vtattyba/NASA-Micro-G-NeXT/AMSAR 1.0/2020 Congrats.jpg

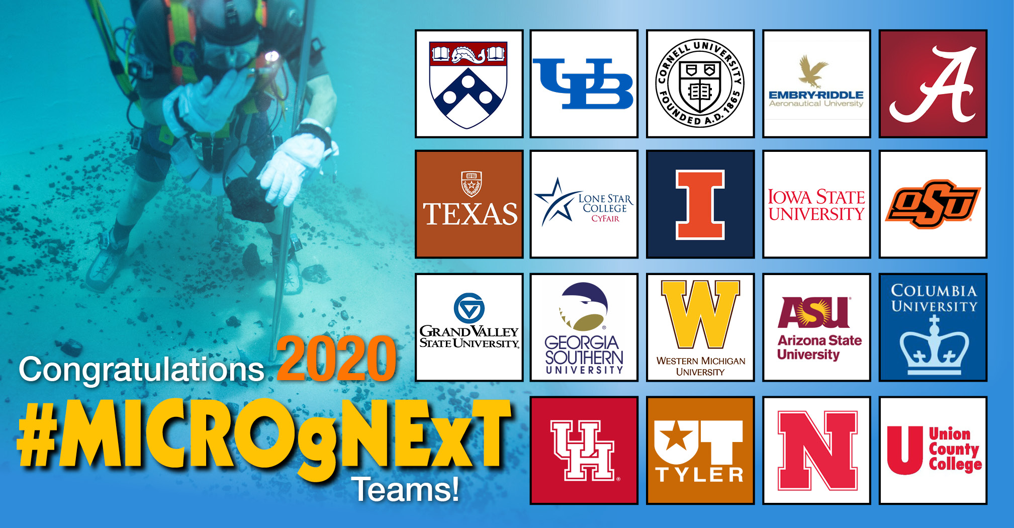
AMSAR 1.0/2020 Congrats.jpg
