vtattyba/NASA-Micro-G-NeXT/AMSAR 1.0/Electronics/custom_pcb.jpg

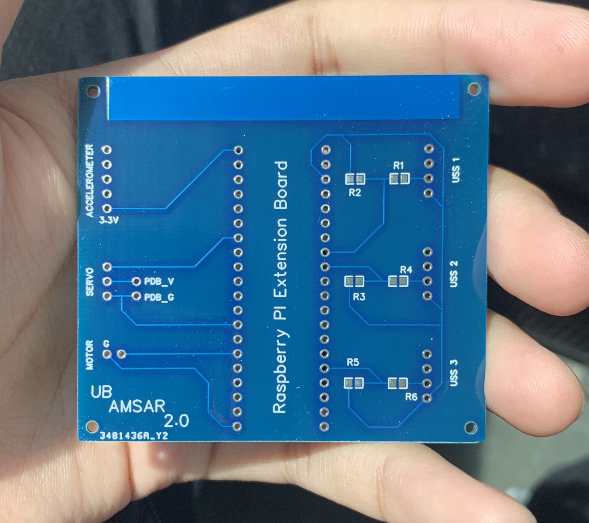
AMSAR 1.0/Electronics/custom_pcb.jpg
