vtattyba/NASA-Micro-G-NeXT/AMSAR 1.0/Electronics/pcb.jpg

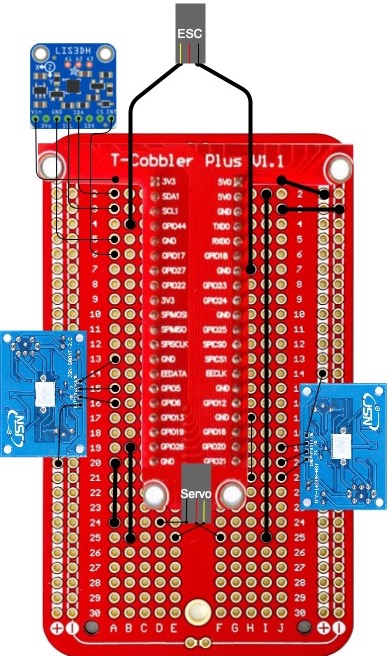
AMSAR 1.0/Electronics/pcb.jpg
