vtattyba/NASA-Micro-G-NeXT/AMSAR 1.0/Media/F1707ED7-14AC-41B5-A841-EFC2B58373EA.JPEG

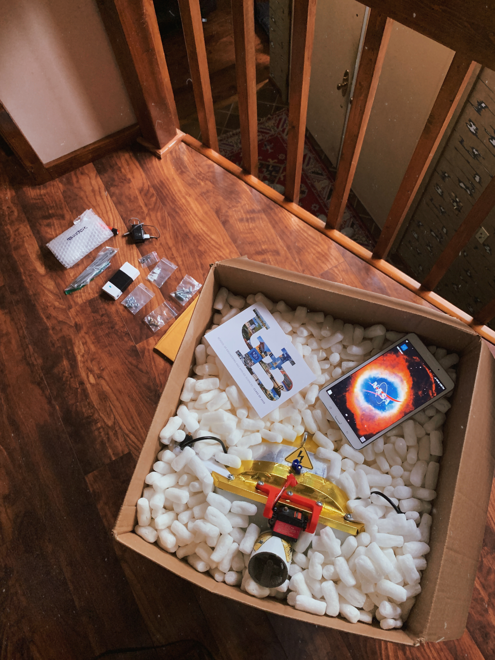
AMSAR 1.0/Media/F1707ED7-14AC-41B5-A841-EFC2B58373EA.JPEG
