vtattyba/NASA-Micro-G-NeXT/AMSAR 1.0/Research/IMG_2271.PNG

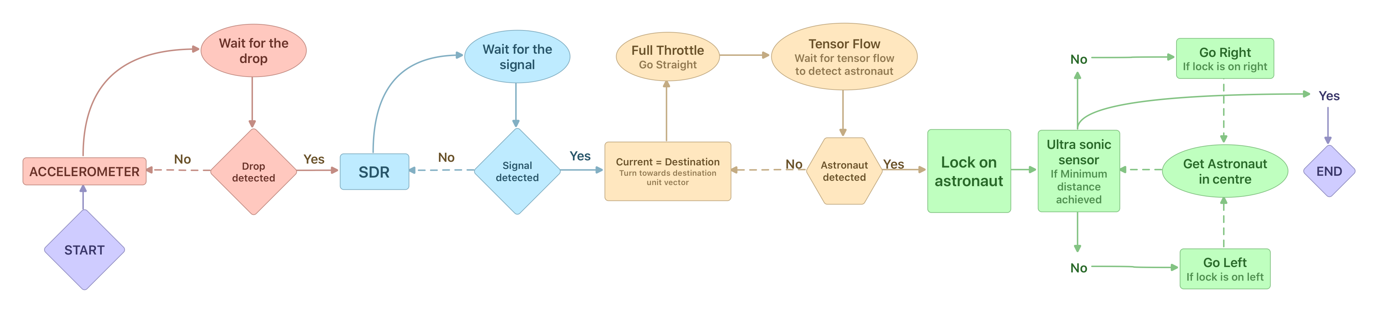
AMSAR 1.0/Research/IMG_2271.PNG
