vtattyba/NASA-Micro-G-NeXT/AMSAR 1.0/Research/Team Research and Development/Basic Function Analysis.jpg

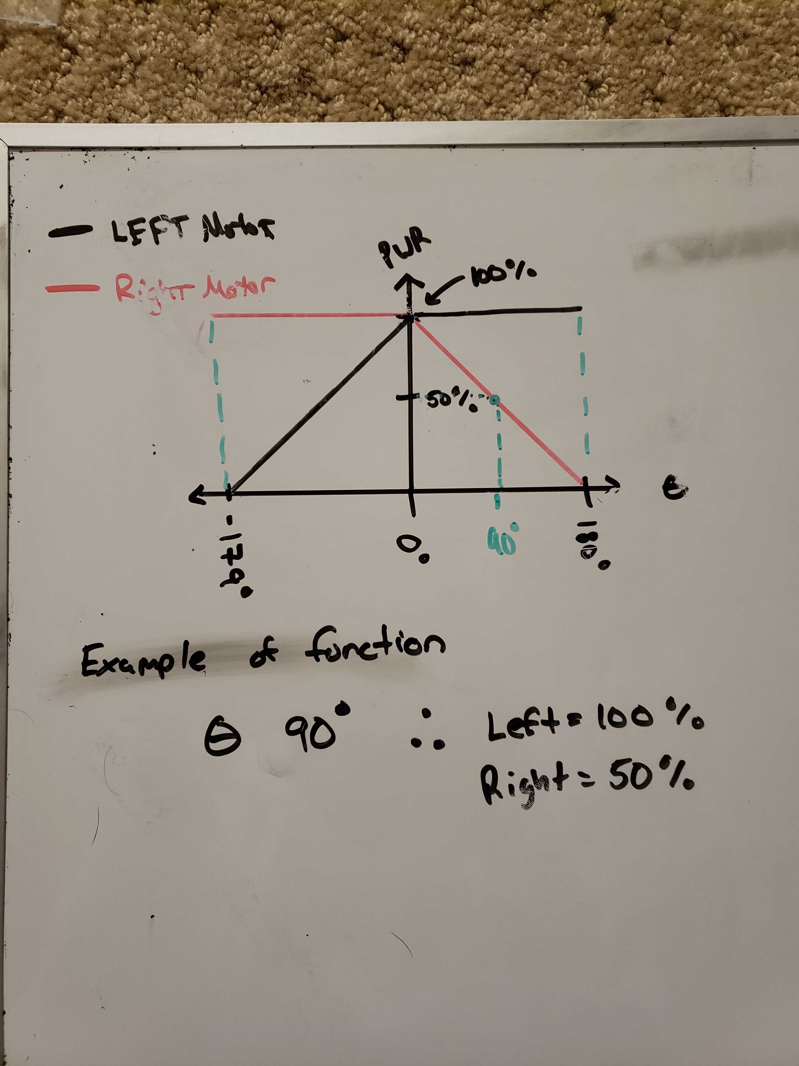
AMSAR 1.0/Research/Team Research and Development/Basic Function Analysis.jpg
