vtattyba/NASA-Micro-G-NeXT/AMSAR 1.0/Research/Team Research and Development/Basic Motor Function (Can Ignore).jpg

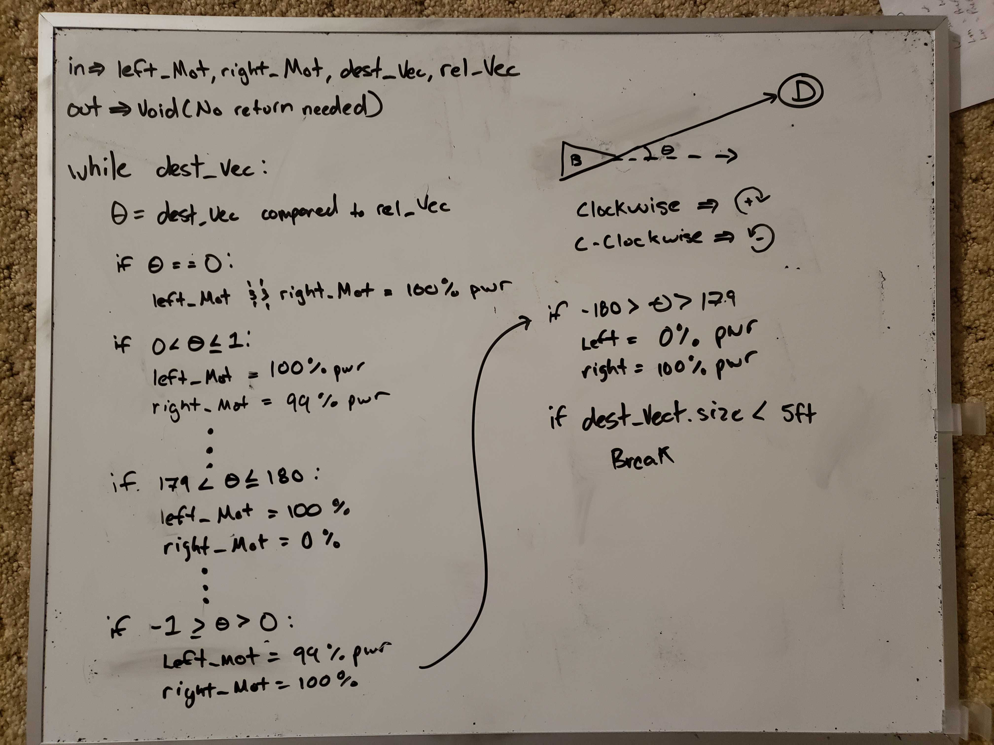
AMSAR 1.0/Research/Team Research and Development/Basic Motor Function (Can Ignore).jpg
