vtattyba/NASA-Micro-G-NeXT/AMSAR 1.0/Research/Team Research and Development/Image from iOS.jpg

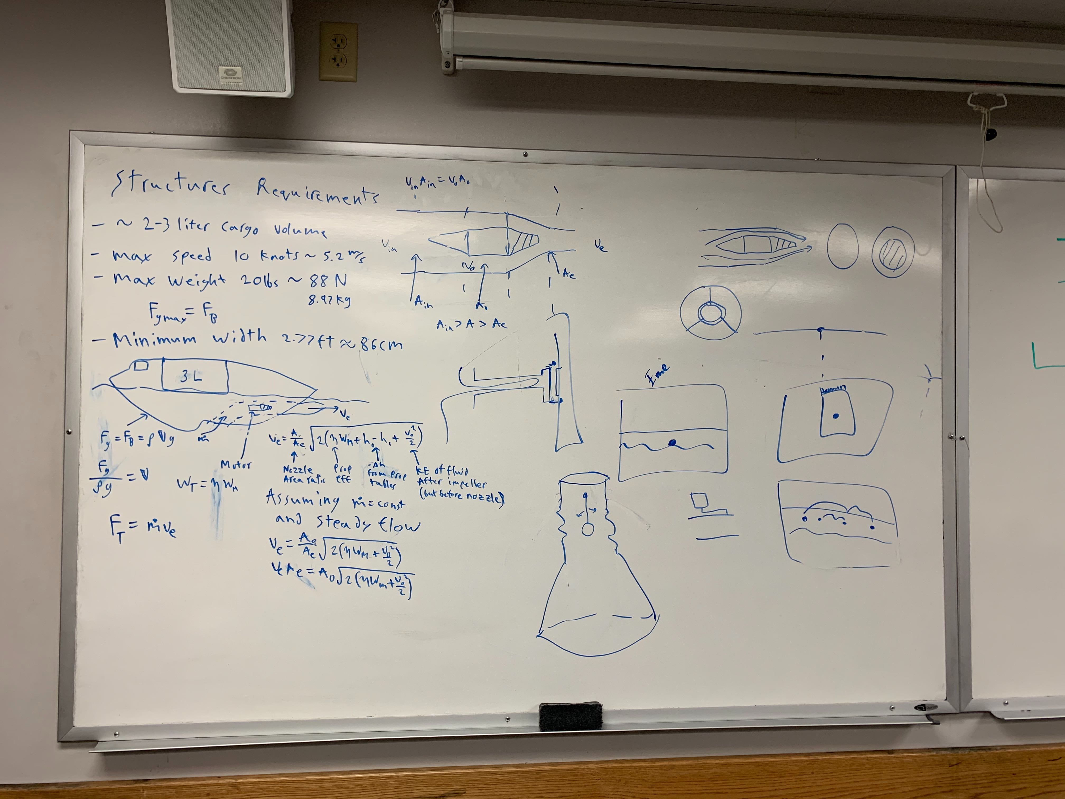
AMSAR 1.0/Research/Team Research and Development/Image from iOS.jpg
