vtattyba/NASA-Micro-G-NeXT/AMSAR 2.0/Electronics/Circuit-2.png

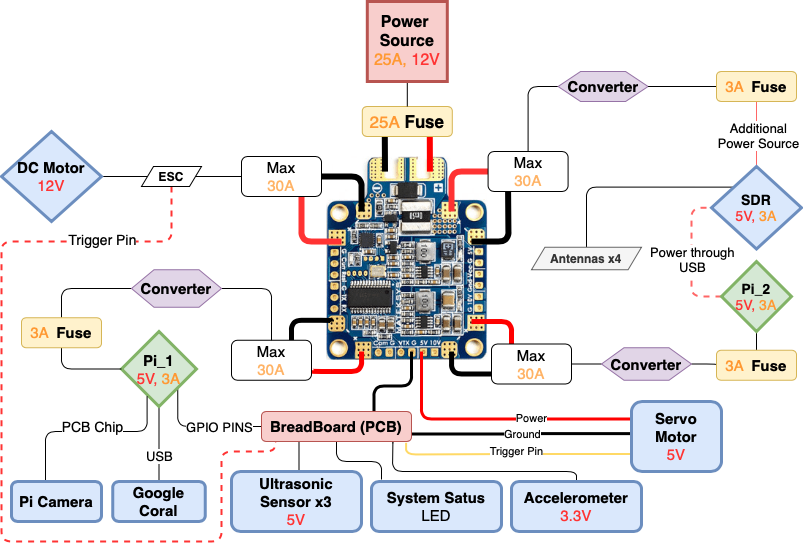
AMSAR 2.0/Electronics/Circuit-2.png
