vtattyba/NASA-Micro-G-NeXT/AMSAR 2.0/Electronics/Custom_PCB.jpg

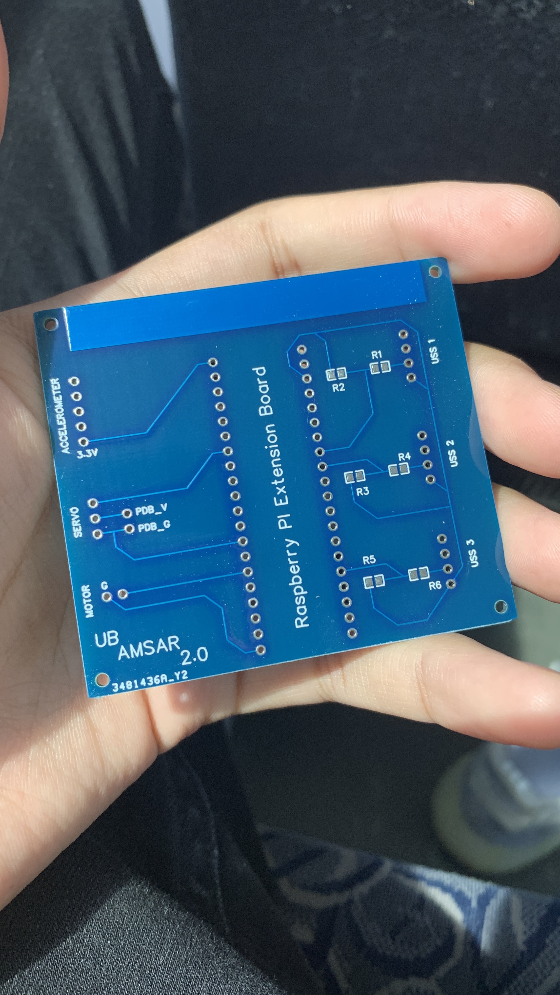
AMSAR 2.0/Electronics/Custom_PCB.jpg
