vtattyba/NASA-Micro-G-NeXT/AMSAR 2.0/Electronics/IMG_9858.jpg

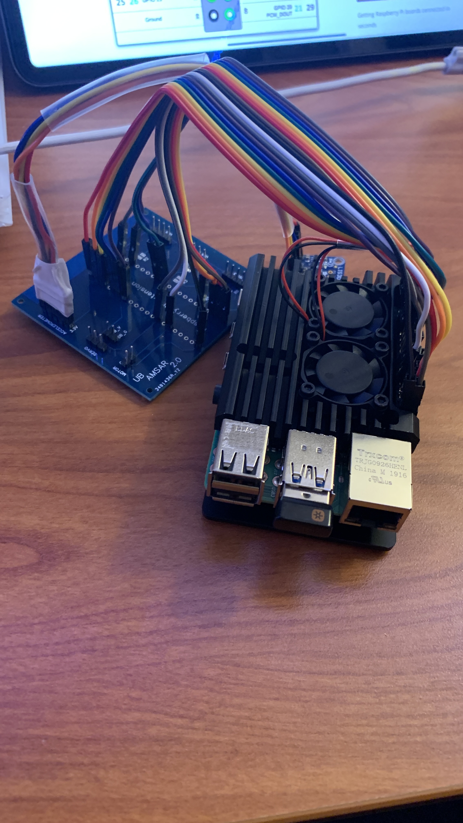
AMSAR 2.0/Electronics/IMG_9858.jpg
