vtattyba/NASA-Micro-G-NeXT/AMSAR 2.0/Software/USS/Screen Shot 2020-08-11 at 8.34.05 PM.png

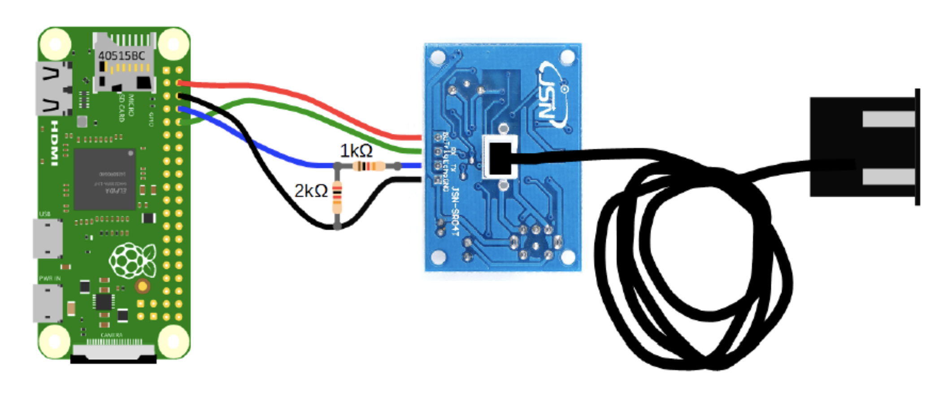
AMSAR 2.0/Software/USS/Screen Shot 2020-08-11 at 8.34.05 PM.png
