vtattyba/NASA-Micro-G-NeXT/AMSAR 2.0/Structures/IMG_9707.jpg

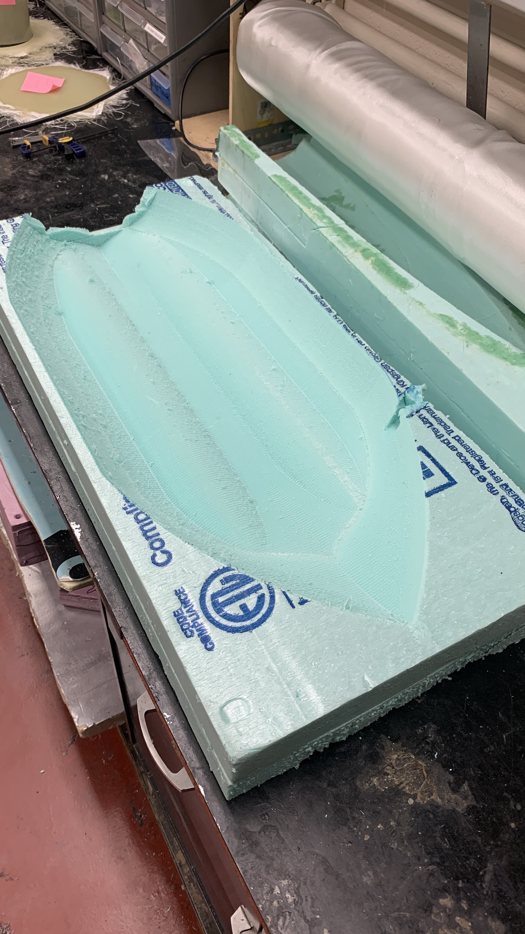
AMSAR 2.0/Structures/IMG_9707.jpg
