vtattyba/NASA-Micro-G-NeXT/AMSAR 2.0/Structures/IMG_9727.JPG

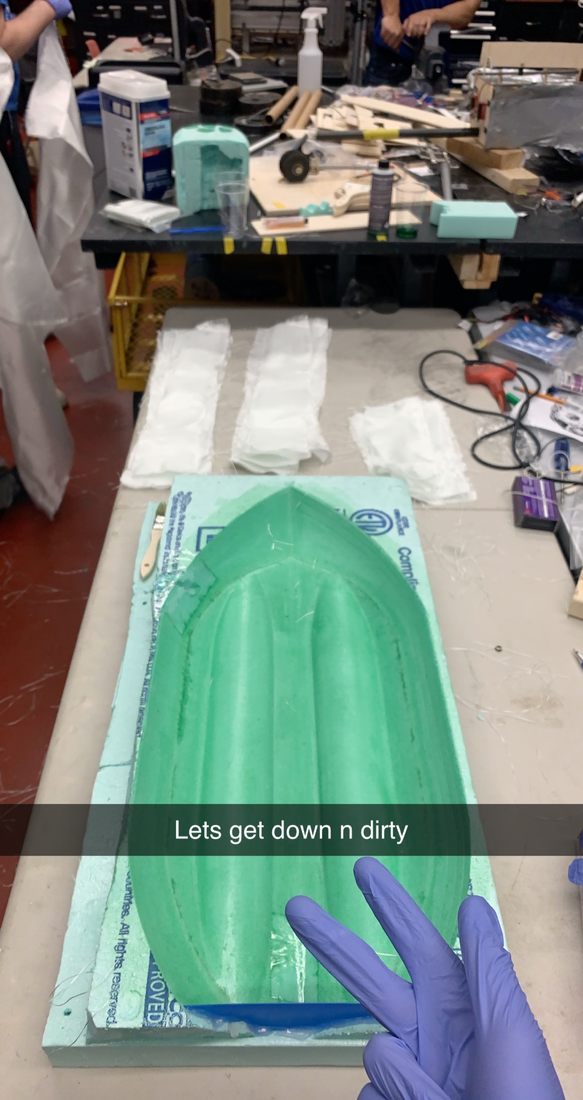
AMSAR 2.0/Structures/IMG_9727.JPG
