vtattyba/NASA-Micro-G-NeXT/AMSAR 1.0/Research/External Research and Citations/Making an Autonomous Boat Using a Raspberry Pi (WiP)_ 14 Steps (with Pictures).html

Instructables instructablescircuitsProjectsCommunity

# Making an Autonomous Boat Using a Raspberry Pi (WiP)

By SilverJimny in CircuitsRaspberry Pi

195,056

539

40

Featured

license StatsDownloadFavorite

 By SilverJimnyCheck out my thingiverse models (https://www.thingiverse.com/GregoryHolloway/designs)Follow

More by the author:

An Electric Musical Instrument 3D Printed Amplifier.

Astrophotography With the Raspberry Pi Zero.

Glow-In-The-Dark Nuclear Bomb Night Light.

About: A passionate make of things. I spend my time developing new ideas and looking for ways to improve old ones! More About SilverJimny »

The wave of enthusiasm for the Raspberry Pi (http://raspberrypi.org) has driven many people to wonder at the possibilities, and marvel at it's simplicity. The credit card sized SBC (http://en.wikipedia.org/wiki/Single-board_computer) is perfect for just about anything. Maybe even for crossing the Atlantic Ocean.

FishPi (http://fishpi.org) is a project with the goal of doing just that and crossing the Atlantic, using the Raspberry Pi to pilot the craft. The first step in this project is the Proof-Of-Concept Vehicle (POCV).

The POCV will test the basic principles of autonomous control with a Raspberry Pi, and I'm going to show you how to make your own.

 (http://steps-per-mm.xyz)

Love 3D printing? Love T-Shirts?

Then you need to check out steps-per-mm.xyz!

It is loaded with a huge range of wearable Parts & Components.

Add TipAsk QuestionCommentDownload

Teacher Notes

Teachers! Did you use this instructable in your classroom?
Add a Teacher Note to share how you incorporated it into your lesson.

Add Teacher Note

Step 1: Parts

The core components used in the FishPi Proof-Of-Concept Vehicle are;

Model B Raspberry Pi (http://raspberrypi.org).
8gb SD Card (http://elinux.org/RPi_VerifiedPeripherals#SD_cards).
Models By Design Fibre Glass Hull (http://modelsbydesign.co.uk/Default.aspx).
Models By Design 40mm Kort Nozzle (http://modelsbydesign.co.uk/Default.aspx).
Raspy Juice (https://code.google.com/p/raspy-juice/).
Flytron Navigatron V2 i2c GPS (http://www.flytron.com/sensors/180-i2c-gps-for-multiwii-and-others.html).
CMPS10 - Tilt Compensated Compass Module (http://www.robot-electronics.co.uk/htm/cmps10doc.htm).
Adafruit 16-Channel 12-bit PWM/Servo Driver - i²c interface - PCA9685 (http://www.adafruit.com/products/815).
Mtronics MicroViper Marine10 Electronic Speed Controller (ESC) (http://www.mtroniks.net/details1.asp/ProductID/185/MicroViper-marine10.htm) .
MFA 919D 540 Motor With Attached Single Ratio Metal Gearbox 2.5:1 (http://www.cornwallmodelboats.co.uk/acatalog/MFA_919D251.html).
Raboesch Brass 4 Bladed Kort Propeller (http://www.cornwallmodelboats.co.uk/acatalog/R149-M4.html).
Raboesch Waterproof Propshaft (http://www.cornwallmodelboats.co.uk/acatalog/Raboesch_Precision_Propshafts.html).
Kinobo 5 Megapixel USB Webcam (http://www.amazon.co.uk/Kinobo-Megapixel-Webcam-Ubuntu-Desktop/dp/B002UAV8LS).
Six 5000mAH 1.2 Volt NiMH SubC cells (http://www.component-shop.co.uk/html/single_cells.html).
Flytron 3.3v & 5v Tiny Regulators (http://www.flytron.com/camera-transmitter-shutter/93-tiny-5volt-regulator.html).
Digital Temperature Sensor Breakout - TMP102 (https://www.sparkfun.com/products/9418).

Tools;

All of them (http://en.wikipedia.org/wiki/Tool).

Additional Parts Used (Update One 18/3/13);

TP-Link TL-WN722N High-Gain Wi-Fi USB Dongle (http://uk.tp-link.com/products/details/?model=TL-WN722N).
RockBLOCK Satellite Communicator (http://rockblock.rock7mobile.com/).
SMA Female to SMA Male Panel Mount Pigtail Extension Cable (http://www.ebay.co.uk/itm/30cm-RP-SMA-Male-to-Female-Pigtail-WLAN-Network-RF-Antenna-RG316-Coaxial-Cable-/230717310910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).
2x 45mm M3 Spacers (http://uk.farnell.com/jsp/search/productdetail.jsp?SKU=1466727).

Please help support my work here on Instructables (https://www.instructables.com/member/SilverJimny/) and on Thingiverse (https://www.thingiverse.com/GregoryHolloway/)
by using the following affiliate links when making purchases. Thanks :)

eBay.com (https://rover.ebay.com/rover/1/711-53200-19255-0/1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) | eBay.co.uk (https://rover.ebay.com/rover/1/710-53481-19255-0/1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) | eBay.fr (https://rover.ebay.com/rover/1/709-53476-19255-0/1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) | Amazon.co.uk (http://amzn.to/2svRleo)

Add TipAsk QuestionCommentDownload

Step 2: The Incredible Hull

The hull I am using for the POCV is based on the Cygnus Marine DS25 (http://www.cygnusmarine.com/boats/specs/specs.asp?lMdl=5) Fishing Boat. It is made by a company called Models By Design (http://modelsbydesign.co.uk/), they specialise in G.R.P. model boats. The hull costs a little over £20, perfect for low budgets.

To begin with the basic components going into the hull are the Motor, Kort Nozzle, Propshaft, Propeller, and servo. The DS25 is not designed to run a Kort nozzle (http://en.wikipedia.org/wiki/Ducted_propeller), but as this system works well at low RPM and high torque, I decided to trial the Kort system with a view to using it in our larger vessels.

The first step is to find the centre line of the hull. To do this is I simply held a ruler against one side of the keel and carefully drew a line along the underside of the model. Repeating this on the opposite edge put two lines on the underside. Next it was just a case of measuring the distance between the two lines and marking up the centre.

To locate holes for the Kort nozzle I had to approximate where the nozzle would be best situated, I did this by viewing the hull side on and taking measurements to get the correct distances.

Inside the hull is a wooden support. This support forms the upper brace for the Kort nozzle, and provides the lower brace for the rudder servo. The support is held in with epoxy resin.

Once the Kort was fitted I used a similar method to locate a hole for the propshaft. The hole for the propshaft was slightly elongated to allow for minor adjustment in height. As long as the elongation was in the vertical plane there should be no deviation off centre in the horizontal. Before finally cementing the propshaft with epoxy take note to align the propshaft with enough room to give the propeller clearance inside the Kort nozzle, even when the nozzle is being steered.

I found that by following the mantra of measure three times, cut once, I reached an accuracy of about 0.5 of a mm when positioning the propeller.

Add TipAsk QuestionCommentDownload

Step 3: Shafted

The MFA 919D 540 Motor (http://www.cornwallmodelboats.co.uk/acatalog/MFA_919D251.html) is fitted with a single ratio gearbox. It increases the motor's torque, but lowers the RPM. It should have no problems driving the 40mm Kort propeller.

The motor needs a strong base to mount onto inside the hull. The underside of the mount is angled to match the slope of the hull. A centre pane slots into the keel giving additional strength.

At the rear the upper servo bracket is added. A universal joint connects the motor output to the propshaft. Some time must be spent correctly aligning the two before permanently fixing the propshaft and motor mount in place.

Add TipAsk QuestionCommentDownload

Step 4: Elastictrickery

Electricity & electronics do not fair well in water. I thought sometime about how to enclose the electronics in a watertight compartment. I looked at several options and in the end I settled on a plastic food storage box.

Why? Well it was cheap, about £3, there are no screws to secure the lid, and they are watertight. The particular box I chose had enough space for the Raspberry Pi, and the four clips which secured the lid to the base were on the lid itself. By building the electronics onto the lid and effectively turning the tub upside down I could un-clip the tub proper so that when it is removed all the electronics are easily accessible.

I cut & shaped a plywood board which would rest inside the lid.The whole assembly is screwed to two cross-members fixed inside the POCV's hull. The two side clips were removed from the lid so the assembly can sit lower in the hull. Onto the wood panel I glued a shaped foam pad, from a Yoga mat, which the Raspberry Pi sits on, and fitted three brackets to hold the Raspberry Pi in position. With the tub, now the lid, clipped in place the enclosure is completely watertight. For now anyway!

Add TipAsk QuestionCommentDownload

Step 5: Wired

Originally the plan was to connect the POCV to a Base-Station via a wired link called we termed as the umbilical. The link would provide connectivity for USB, HDMI, & CAT5e. In total there were 32 separate wires across the USB, HDMI, and Network cables. The design utilised a 32 pin aviation style connector and a 2 metre cable.

Wires would connect to the Raspberry Pi, pass through the lid of the watertight compartment and into the 32-pin connector. This would then be replicated at the other end where the cable would plug into an LCD, USB hub, and a offer a network connection.

Recently this system has been removed as it caused too many problems. The umbilical is being replaced with a Wifi link. Details of this conversion are shown later on.

Add TipAsk QuestionCommentDownload

Step 6: Staying Power

Six 1.2v 5000mAh SubC NiMh batteries. Quite a mouthful, they all need securely fitting into the POCV's hull, along with a switch control box.

The box switches the battery connections between a DC socket, and supplying power to the POCV. By plugging a NiMh charger into the DC socket, and with the switch it in the correct position we can charge the six cells without needing to remove them from inside the hull.

To help balance the board I put two at the rear, below the tub, and four at the front. They are held in with tie-wraps. I have used several connectors so that the batteries can be removed if necessary.

Add TipAsk QuestionCommentDownload

Step 7: Power Rails

The six NiMh cells are arranged in series, this gives 7.2 volts. The Raspberry Pi works off 5 volts, and the i2c rail needs 3.3 volts.

I bought two 5v, and a single 3.3v LDO regulator from Flytron (http://flytron.com/). The extra 5v would be used for any other devices, like a webcam and the Adafruit PWM, that would be built into the POCV.

The LDOs convert any difference in voltage (7.2v to 5v, 3.3v) into heat. I used a passive heat-sink removed from an old mainboard, cut it into lengths that loosely matched the shape of the LDOs, and then strapped the LDOs to the heat-sink with a bit of thermal pad between the LDO and the heat-sink. This design was later updated where the tie-wraps and thermal pads were replaced with thermal adhesive. The three LDOs are screwed to tabs glued onto the wood panel.

The i2c rails are made from strip-board. Lines for +v, gnd, SDA, & SLC, are connected with 2.54mm pins. 3.3v is fed from the 3.3v LDO. Included on the i2c rails are two 1k8 pick-up resistors.

Mounted to wooden blocks at the front is the Mtronics MicroViper Marine10 (http://www.mtroniks.net/details1.asp/ProductID/185/MicroViper-marine10.htm) ESC.

Add TipAsk QuestionCommentDownload

Step 8: The Little Things

The TMP102 Temperature Sensor (https://www.sparkfun.com/products/9418), Navigatron v2 GPS (http://www.flytron.com/sensors/180-i2c-gps-for-multiwii-and-others.html), CMPS10 Compass (http://www.robot-electronics.co.uk/htm/cmps10doc.htm), and the Adafruit 16 Channel PWM (http://www.adafruit.com/products/815) all connect to the i2c rails using 2.54mm pins. By encasing DuPont connectors in wood, and then gluing them to the wood panel I was able to fit all the devices into the tub, and make them all removable.

CMPS10 Compass needs to be as far away from other electronics as it is susceptible to interference. The compass is mounted inside a plastic box on a mast at the front of the POCV.

To check that all the power systems work the POCV is plugged into an LCD and turned on.

Add TipAsk QuestionCommentDownload

Step 9: I Spy

The small form factor of the Kinobo Webcam (http://www.amazon.co.uk/Kinobo-Megapixel-Webcam-Ubuntu-Desktop/dp/B002UAV8LS) combined with its practical rectangular shape are the main reasons for picking this camera.

One of our goals is to be able to record and hopefully transmit live images back from the mid Atlantic. I decided early on that adding in a webcam would be a addition to the POCV. The Raspberry Pi Foundation (http://raspberrypi.org) are developing a camera to work with the Raspberry Pi, but at the time of writing this the camera is not currently available.

Add TipAsk QuestionCommentDownload

Step 10: Spray 'N Pray

Take care when masking the hull making sure to to cover the holes, plastic parts, and any other areas where you do not want paint. I used a bin liner and modelling masking tape.

The model is hung outside on a modified wire coat hanger for spraying.

The lettering is Letraset Transfers (http://www.letraset.com/products/91-Lettering/). The letters are applied after painting, and several coats of protective varnish are sprayed over the top. The interior of the hull also gets a few coasts of the protective varnish.

The hooks around the edge are one part of a Hook & Eye (http://en.wikipedia.org/wiki/Hook-and-eye_closure) system designed to hold a cloth cover over the top of the POCV.

Add TipAsk QuestionCommentDownload

Step 11: Putting It Together

Putting the POCV together for the final assembly I had to pass the wires through the wood panel and solder the 32 separate wires to the 32-pin connector. The first attempt didn't work very well and I had to rebuild the entire cable, at both ends, using heatshrink over all the pins where the wire soldered on. In the end it proved to complicated too make it a practical solution.

Add TipAsk QuestionCommentDownload

Step 12: The First Modification

As with all prototypes, things need altering from their original design. The first modification to the POCV was the Raspy Juice (https://code.google.com/p/raspy-juice/). The LDO supplying the Raspberry Pi with 5v was getting very hot, even with the heat-sink. Luckily FishPi had been sent two Raspy Juice beta boards for testing so it was a simple case of unplugging the LDO and wiring in the Raspy Juice.

The next upgrade was the USB hub. Removing the umbilical and installing a Wifi link between the POCV and the Base-Station. The power needs of the Wifi Dongle would exceed the capabilities of the Raspberry Pi's on-board USB. So a powered USB hub was needed. I had an old 4-Port un-powered USB hub which I modified to take a 5v feed from the unused LDO which used to power Raspberry Pi.

There are still a few additions to go onto the POCV, including a Satellite Communications Module (RockBLOCK (http://rockblock.rock7mobile.com/)), I will post updates as the Proof-Of-Concept Vehicle's development grows.

Add TipAsk QuestionCommentDownload

Step 13: Software

Good software is the life & soul of every project.

FishPi is no different. The Command & Control software under development for the POCV is open source. We have a repository on GitHub (link (http://github.com/FishPi/FishPi-POCV---Command---Control)) where you can download a copy of your own, or help with development and fork from our repository. You can follow software development updates on twitter @TheFishPi_Dev (http://twitter.com/TheFishPi_Dev).

For now we have manual control of the POCV through the Command & Control software. Al Gray, our lead programmer, is working hard to adjust the system to handle the new remote requirements imposed by the substitution of the umbilical for a Wifi link.

Ultimately we should have a system capable of autonomous navigation, satellite communications, live video feeds, and remote control. The Command & Control program should also work on any vehicle type, not just boats.

For more information about FishPi please visit our website http://www.fishpi.org, join our forum http://fishpi.org/forum/, or follow us on twitter @TheFishPi (http://twitter.com/TheFishPi). We also have a wiki if you're looking for the full technical details http://wiki.fishpi.org/

Add TipAsk QuestionCommentDownload

Step 14: 18 March 2013 | Update One

There has been an alteration to the FishPi's communications. The 32-core umbilical has been removed, and a Wi-Fi link has been fitted in it's place. I'll also be adding in a RockBLOCK Satellite Communicator (http://rockblock.rock7mobile.com/).

After checking the eLinux.Org list of Raspberry Pi Verified Peripherals (http://elinux.org/Rpi_Low-level_peripherals) for a compatible Wi-Fi dongle I chose the TP-Link TL-WN722N. The TP-Link has a detachable High-Gain Antenna which will be perfect to use with an RF extension.

The first job is to remove all the unwanted plastic casing from the dongle. Because I will be soldering a wire to the dongle I have also unsoldered the USB plug.

There isn't much space left inside the lunch-box enclosure so the RockBLOCK will be mounted on PCB supports where it will sit above the Raspberry Pi. I used eight 12mm M3 brass supports during the modification, but I have since replaced them with two 45mm M3 supports.

The Wi-Fi Dongle sits vertically inside two notched wooden support posts, one is permanently fixed but the other is held in by a screw. Both the Wi-Fi Dongle and the RockBLOCK have USB cables soldered directly to the PCBs.

The lunch-box base, now the cover, has been drilled and an RF extension cable mounted inside the hole. The antenna which somes with the Wi-Fi Dongle has been screwed to the extension. The other end of the RF extension attaches to the Wi-Fi Dongle.

Additional Parts Used;

TP-Link TL-WN722N High-Gain Wi-Fi USB Dongle (http://uk.tp-link.com/products/details/?model=TL-WN722N).
RockBLOCK Satellite Communicator (http://rockblock.rock7mobile.com/).
SMA Female to SMA Male Panel Mount Pigtail Extension Cable (http://www.ebay.co.uk/itm/30cm-RP-SMA-Male-to-Female-Pigtail-WLAN-Network-RF-Antenna-RG316-Coaxial-Cable-/230717310910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).
2x 45mm M3 Spacers (http://uk.farnell.com/jsp/search/productdetail.jsp?SKU=1466727).

The Base-Station is now an instructable too | Creating A Base-Station For Use With An Autonomous Vehicle (https://www.instructables.com/id/Creating-a-Base-Station-for-Use-With-An-Autonomous/).

Add TipAsk QuestionCommentDownload

UP! Contest
Participated in the
UP! Contest
View Contest

2 People Made This Project!

not an autonomous on...-chalei
chalei made it!

This project gave me...-comsa42
comsa42 made it!

Did you make this project? Share it with us!
I Made It!

Recommendations

Ultimate Dry Ice Machine - Bluetooth Controlled, Battery Powered and 3D Printed.

Ultimate Dry Ice Machine - Bluetooth Controlled, Battery Powered and 3D Printed.

by DIY Machines in Circuits

Commodore 64 Revamp With Raspberry Pi, Arduino and Lego

Commodore 64 Revamp With Raspberry Pi, Arduino and Lego

by RaspberryPioneer in Raspberry Pi

ILC1-1/8L Clock

ILC1-1/8L Clock

by ChristineNZ in Arduino

Internet of Things Class
Internet of Things Class
Internet of Things Class

22,645 Enrolled

Made with Math Contest
Made with Math Contest

Multi-Discipline Contest
Multi-Discipline Contest

Robotics Contest
Robotics Contest

40 Discussions

0

None

DanRadin
2 years ago

ReplyUpvote

Hi, thank you for sharing your great project. I am a math, science, and technology teacher at a small school http://www.panajachelcolegio.org/ on Lake Atitlan in Guatemala. We have a lot of problems with garbage in the lake. My students and I are thinking of building an autonomous boat to travel around the shore of the lake cleaning up garbage. I am thinking of using your instructable to build a miniature prototype. Perhaps you would like to collaborate with us.

0

None

Wallie45
2 years ago

ReplyUpvote

Hey any update on this? Do you still have the program for running the boat?

0

None

gaurav_sharma132
3 years ago

ReplyUpvote

What range did you able get with that wifi dongle concerning video feed and all ?

0

None

gaurav_sharma132
3 years ago

ReplyUpvote

What range did you able get with that wifi dongle concerning video feed and all ?

0

None

DavidGuo
3 years ago

ReplyUpvote

Good job! I think the LoRa/GPS HAT must be a good choice if you try to use the Wireless Lora Protocol at your project !

1 reply

0

None

DavidGuoDavidGuo
Reply 3 years ago

ReplyUpvote

LoRa/GPS HAT

http://wiki.dragino.com/index.php?title=Lora/GPS_HAT

0

None

NateS14
3 years ago

ReplyUpvote

So I want to create a small version that goes in my pond and livestream the fish. Is there a way to have it just drive around the pond randomly?

0

None

ZachSchleder
4 years ago on Introduction

ReplyUpvote

0

None

royalhackerx
4 years ago on Introduction

ReplyUpvote

i want its Pdf with circuit diagram how can i get it???

1 reply

0

None

SilverJimnyroyalhackerx
Reply 4 years ago on Introduction

ReplyUpvote

There isn't one available so you'd have to make one.

0

None

thebarboy
4 years ago on Introduction

ReplyUpvote

sorry, I will try with ardiuno. can ı do ?, and can u help to me ?

1 reply

0

None

SilverJimnythebarboy
Reply 4 years ago on Introduction

ReplyUpvote

You probably can do but I don't know how!

Google it :)

0

None

kane71270
5 years ago on Step 13

ReplyUpvote

I don't understand how you will transfer live feed with the limitations that RockBlock's 340 byte message limitation. Could you go into more details on this?

1 reply

0

None

SilverJimnykane71270
Reply 4 years ago on Introduction

ReplyUpvote

Neither do I!

It's problem for now....

0

None

KarthikG3
4 years ago on Introduction

ReplyUpvote

0

None

Glany2160
5 years ago on Introduction

ReplyUpvote

Now, all this needs is a quadcopter strapped on top for the perfect, fully autonomous river explorer!

0

None

cdragos george
5 years ago on Introduction

ReplyUpvote

In this tutorial I find what I need to start interfacing the gps sensor with a Pi board. And because I want to help many more hobbyists to start building robots, I share this tutorial on my post http://www.intorobotics.com/gps-sensors-tutorials-resources/. Thank you!

0

None

Samuel kos
6 years ago

ReplyUpvote

Sry I hadn't no diced the others comments on this nevermind

0

None

Samuel kos
6 years ago

ReplyUpvote

You shod probably install a solar panel to charge the batteried

0

None

ToolboxGuy
6 years ago on Step 14

ReplyUpvote

Quite a feat to accomplish! Not sure how you intend to charge the batteries whilst travelling across the ocean.... 6D batteries can barely run a few flashlights overnight, and this boat will have to be running its motor for months, plus the on board camera and other electronics.

More CommentsPost Comment

Categories

Circuits

Workshop

Craft

Cooking

Living

Outside

Teachers

About Us

Who We Are

Why Publish?

Jobs

Resources

Sitemap

Help

Contact

Find Us

instagram (https://www.instagram.com/instructables/)

pinterest (https://www.pinterest.com/instructables)

facebook (https://www.facebook.com/instructables)

twitter (https://www.twitter.com/instructables)

© 2019 Autodesk, Inc.

Terms of Service (http://usa.autodesk.com/adsk/servlet/item?siteID=123112&id=21959721)|

Privacy Statement (http://usa.autodesk.com/adsk/servlet/item?siteID=123112&id=21292079)|

Privacy settings|

Legal Notices & Trademarks (http://usa.autodesk.com/legal-notices-trademarks/)

autodesk (http://www.autodesk.com)
