vtattyba/NASA-Micro-G-NeXT/AMSAR 1.0/Research/Team Research and Development/Shell Shape Assembly 2 FRONT.bmp

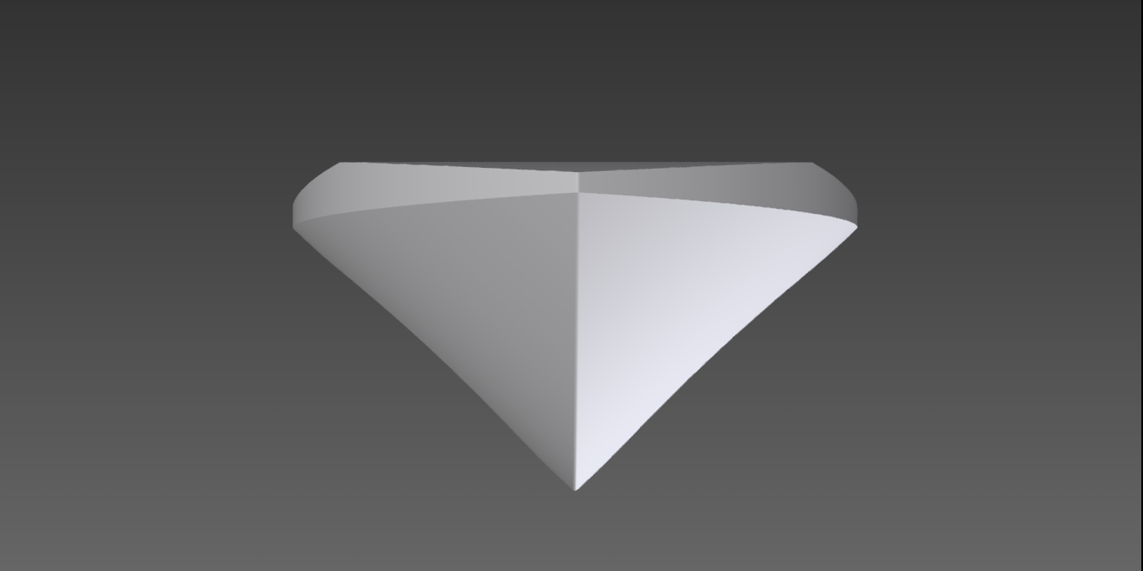
AMSAR 1.0/Research/Team Research and Development/Shell Shape Assembly 2 FRONT.bmp
