vtattyba/NASA-Micro-G-NeXT/AMSAR 1.0/Software/TensorFlow/models/official/r1/wide_deep/census_test.csv

39 | State-gov | 77516 | Bachelors | 13 | Never-married | Adm-clerical | Not-in-family | 2174 | 0 | 40 | <=50K
50 | Self-emp-not-inc | 83311 | Bachelors | 13 | Married-civ-spouse | Exec-managerial | Husband | 0 | 0 | 13 | <=50K
38 | Private | 215646 | HS-grad | 9 | Divorced | Handlers-cleaners | Not-in-family | 0 | 0 | 40 | <=50K
53 | Private | 234721 | 11th | 7 | Married-civ-spouse | Handlers-cleaners | Husband | 0 | 0 | 40 | <=50K
28 | Private | 338409 | Bachelors | 13 | Married-civ-spouse | Prof-specialty | Wife | 0 | 0 | 40 | <=50K
37 | Private | 284582 | Masters | 14 | Married-civ-spouse | Exec-managerial | Wife | 0 | 0 | 40 | <=50K
49 | Private | 160187 | 9th | 5 | Married-spouse-absent | Other-service | Not-in-family | 0 | 0 | 16 | <=50K
52 | Self-emp-not-inc | 209642 | HS-grad | 9 | Married-civ-spouse | Exec-managerial | Husband | 0 | 0 | 45 | >50K
31 | Private | 45781 | Masters | 14 | Never-married | Prof-specialty | Not-in-family | 14084 | 0 | 50 | >50K
42 | Private | 159449 | Bachelors | 13 | Married-civ-spouse | Exec-managerial | Husband | 5178 | 0 | 40 | >50K
37 | Private | 280464 | Some-college | 10 | Married-civ-spouse | Exec-managerial | Husband | 0 | 0 | 80 | >50K
30 | State-gov | 141297 | Bachelors | 13 | Married-civ-spouse | Prof-specialty | Husband | 0 | 0 | 40 | >50K
23 | Private | 122272 | Bachelors | 13 | Never-married | Adm-clerical | Own-child | 0 | 0 | 30 | <=50K
32 | Private | 205019 | Assoc-acdm | 12 | Never-married | Sales | Not-in-family | 0 | 0 | 50 | <=50K
40 | Private | 121772 | Assoc-voc | 11 | Married-civ-spouse | Craft-repair | Husband | 0 | 0 | 40 | >50K
34 | Private | 245487 | 7th-8th | 4 | Married-civ-spouse | Transport-moving | Husband | 0 | 0 | 45 | <=50K
25 | Self-emp-not-inc | 176756 | HS-grad | 9 | Never-married | Farming-fishing | Own-child | 0 | 0 | 35 | <=50K
32 | Private | 186824 | HS-grad | 9 | Never-married | Machine-op-inspct | Unmarried | 0 | 0 | 40 | <=50K
38 | Private | 28887 | 11th | 7 | Married-civ-spouse | Sales | Husband | 0 | 0 | 50 | <=50K
43 | Self-emp-not-inc | 292175 | Masters | 14 | Divorced | Exec-managerial | Unmarried | 0 | 0 | 45 | >50K
40 | Private | 193524 | Doctorate | 16 | Married-civ-spouse | Prof-specialty | Husband | 0 | 0 | 60 | >50K
56 | Local-gov | 216851 | Bachelors | 13 | Married-civ-spouse | Tech-support | Husband | 0 | 0 | 40 | >50K
54 | ? | 180211 | Some-college | 10 | Married-civ-spouse | ? | Husband | 0 | 0 | 60 | >50K
22 | State-gov | 311512 | Some-college | 10 | Married-civ-spouse | Other-service | Husband | 0 | 0 | 15 | <=50K
31 | Private | 84154 | Some-college | 10 | Married-civ-spouse | Sales | Husband | 0 | 0 | 38 | >50K
57 | Federal-gov | 337895 | Bachelors | 13 | Married-civ-spouse | Prof-specialty | Husband | 0 | 0 | 40 | >50K
47 | Private | 51835 | Prof-school | 15 | Married-civ-spouse | Prof-specialty | Wife | 0 | 1902 | 60 | >50K
50 | Federal-gov | 251585 | Bachelors | 13 | Divorced | Exec-managerial | Not-in-family | 0 | 0 | 55 | >50K
25 | Private | 289980 | HS-grad | 9 | Never-married | Handlers-cleaners | Not-in-family | 0 | 0 | 35 | <=50K
42 | Private | 116632 | Doctorate | 16 | Married-civ-spouse | Prof-specialty | Husband | 0 | 0 | 45 | >50K
