vtattyba/NASA-Micro-G-NeXT/AMSAR 1.0/Software/TensorFlow/models/research/object_detection/images/test_labels.csv

filename | width | height | class | xmin | ymin | xmax | ymax
IMG_20191021_184814.jpg | 480 | 480 | chapstick | 225 | 181 | 298 | 324
IMG_20191021_184819.jpg | 480 | 480 | chapstick | 144 | 202 | 308 | 251
IMG_20191021_184935.jpg | 480 | 480 | chapstick | 210 | 258 | 333 | 369
IMG_20191021_185019.jpg | 480 | 480 | chapstick | 191 | 187 | 292 | 347
IMG_20191021_185022.jpg | 480 | 480 | chapstick | 174 | 220 | 295 | 318
IMG_20191021_185034.jpg | 480 | 480 | chapstick | 273 | 273 | 303 | 312
IMG_20191021_185647.jpg | 306 | 408 | chapstick | 155 | 205 | 173 | 228
IMG_20191021_185654.jpg | 306 | 408 | chapstick | 142 | 186 | 190 | 283
IMG_20191021_185722.jpg | 306 | 408 | chapstick | 116 | 198 | 156 | 244
IMG_20191021_185730.jpg | 480 | 480 | chapstick | 204 | 234 | 227 | 302
IMG_20191021_185852.jpg | 480 | 480 | chapstick | 199 | 240 | 288 | 313
IMG_20191021_185857.jpg | 480 | 480 | chapstick | 207 | 198 | 224 | 258
IMG_20191021_185911.jpg | 480 | 480 | chapstick | 214 | 201 | 233 | 268
IMG_20191021_185919.jpg | 480 | 480 | chapstick | 162 | 240 | 274 | 285
IMG_20191021_194022_1.jpg | 960 | 960 | chapstick | 446 | 244 | 535 | 491
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
