vtattyba/NASA-Micro-G-NeXT/AMSAR 1.0/Software/TensorFlow/models/research/object_detection/images/test/IMG_20191021_184814.jpg

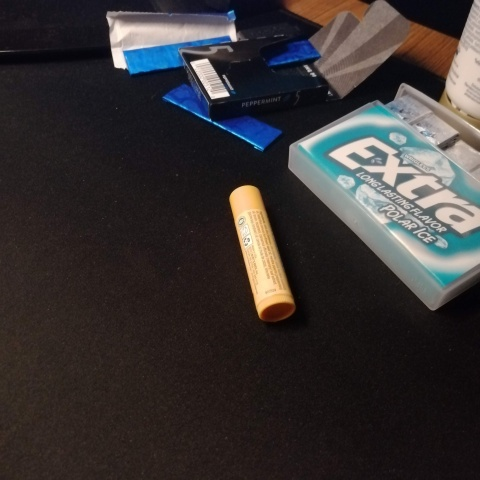
AMSAR 1.0/Software/TensorFlow/models/research/object_detection/images/test/IMG_20191021_184814.jpg
