vtattyba/NASA-Micro-G-NeXT/AMSAR 1.0/DOCUMENTS/AMSAR PROJECT TIMELINE.pdf

# ea AMSAR

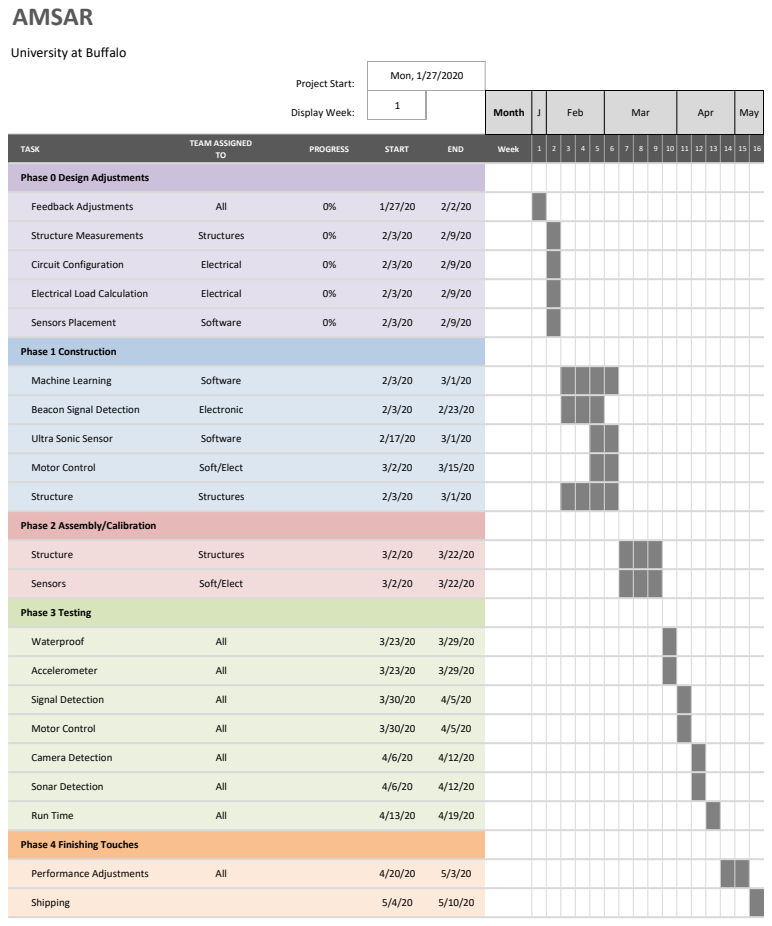
[picture p129: page 1]
TASK; TEAM ASSIGNED; PROGRESS; START; END; Week; Do not delete this row. This row is hidden to preserve a formula that is used to highlight the current day within the project schedule. Feedback Adjustments; All; Structure Measurements; Structures; Circuit Configuration; Electrical; Electrical Load Calculation; Sensors Placement; Software; Phase 1 Construction; Machine Learning; Beacon Signal Detection; Electronic; Ultra Sonic Sensor; Motor Control; Soft/Elect; Structure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

Enter Company Name in cell B2. University at Buffalo

Enter the name of the Project Lead in cell B3. Enter the Project Start date in cell E3. Project Start: label is in cell C3.

Sample phase title block Phase 0 Design Adjustments

Sample phase title block Phase 3 Testing

Sample phase title block Phase 4 Finishing Touches
