vtattyba/NASA-Micro-G-NeXT/AMSAR 1.0/FInal 1.0/Final2/detection.py

######## Webcam Object Detection Using Tensorflow-trained Classifier #########
#
# Author: Evan Juras
# Date: 10/27/19
# Description: 
# This program uses a TensorFlow Lite model to perform object detection on a live webcam
# feed. It draws boxes and scores around the objects of interest in each frame from the
# webcam. To improve FPS, the webcam object runs in a separate thread from the main program.
# This script will work with either a Picamera or regular USB webcam.
#
# This code is based off the TensorFlow Lite image classification example at:
# https://github.com/tensorflow/tensorflow/blob/master/tensorflow/lite/examples/python/label_image.py
#
# I added my own method of drawing boxes and labels using OpenCV.
# Import packages
import os
import argparse
import cv2
import numpy as np
import sys
import time
import importlib.util
from threading import Thread

# Define VideoStream class to handle streaming of video from webcam in separate processing thread
# Source - Adrian Rosebrock, PyImageSearch: https://www.pyimagesearch.com/2015/12/28/increasing-raspberry-pi-fps-with-python-and-opencv/
class VideoStream:
    """Camera object that controls video streaming from the Picamera"""
    def __init__(self,resolution=(640,480),framerate=30):
        # Initialize the PiCamera and the camera image stream
        self.stream = cv2.VideoCapture(0)
        ret = self.stream.set(cv2.CAP_PROP_FOURCC, cv2.VideoWriter_fourcc(*'MJPG'))
        ret = self.stream.set(3,resolution[0])
        ret = self.stream.set(4,resolution[1])
            
        # Read first frame from the stream
        (self.grabbed, self.frame) = self.stream.read()

    # Variable to control when the camera is stopped
        self.stopped = False

    def start(self):
    # Start the thread that reads frames from the video stream
        Thread(target=self.update,args=()).start()
        return self

    def update(self):
        # Keep looping indefinitely until the thread is stopped
        while True:
            # If the camera is stopped, stop the thread
            if self.stopped:
                # Close camera resources
                self.stream.release()
                return

            # Otherwise, grab the next frame from the stream
            (self.grabbed, self.frame) = self.stream.read()

    def read(self):
    # Return the most recent frame
        return self.frame

    def stop(self):
    # Indicate that the camera and thread should be stopped
        self.stopped = True
        
        
        
class Detector:
    def __init__(self):
        print('intializing tensorflow lite...')
        MODEL_NAME = '/home/pi/tflite1/Sample_TFLite_model'
        GRAPH_NAME = 'detect.tflite'
        LABELMAP_NAME = 'labelmap.txt'
        self.min_conf_threshold = float(0.5)
        imW, imH = 640, 480
        use_TPU = True
        # Import TensorFlow libraries
        # If tflite_runtime is installed, import interpreter from tflite_runtime, else import from regular tensorflow
        # If using Coral Edge TPU, import the load_delegate library
        pkg = importlib.util.find_spec('tflite_runtime')
        if pkg:
            from tflite_runtime.interpreter import Interpreter
            if use_TPU:
                from tflite_runtime.interpreter import load_delegate
        else:
            from tensorflow.lite.python.interpreter import Interpreter
            if use_TPU:
                from tensorflow.lite.python.interpreter import load_delegate

        # If using Edge TPU, assign filename for Edge TPU model
        if use_TPU:
            # If user has specified the name of the .tflite file, use that name, otherwise use default 'edgetpu.tflite'
            if (GRAPH_NAME == 'detect.tflite'):
                GRAPH_NAME = 'edgetpu.tflite'       

        # Get path to current working directory
        CWD_PATH = os.getcwd()

        # Path to .tflite file, which contains the model that is used for object detection
        PATH_TO_CKPT = os.path.join(CWD_PATH,MODEL_NAME,GRAPH_NAME)

        # Path to label map file
        PATH_TO_LABELS = os.path.join(CWD_PATH,MODEL_NAME,LABELMAP_NAME)

        # Load the label map
        with open(PATH_TO_LABELS, 'r') as f:
            self.labels = [line.strip() for line in f.readlines()]

        # Have to do a weird fix for label map if using the COCO "starter model" from
        # https://www.tensorflow.org/lite/models/object_detection/overview
        # First label is '???', which has to be removed.
        if self.labels[0] == '???':
            del(self.labels[0])

        # Load the Tensorflow Lite model.
        # If using Edge TPU, use special load_delegate argument
        if use_TPU:
            self.interpreter = Interpreter(model_path=PATH_TO_CKPT,
                                      experimental_delegates=[load_delegate('libedgetpu.so.1.0')])
            print(PATH_TO_CKPT)
        else:
            self.interpreter = Interpreter(model_path=PATH_TO_CKPT)

        self.interpreter.allocate_tensors()
        
        # Get model details
        self.input_details = self.interpreter.get_input_details()
        self.output_details = self.interpreter.get_output_details()
        self.height = self.input_details[0]['shape'][1]
        self.width = self.input_details[0]['shape'][2]

        self.floating_model = (self.input_details[0]['dtype'] == np.float32)

        input_mean = 127.5
        input_std = 127.5

        # Initialize video stream
        self.videostream = VideoStream(resolution=(imW,imH),framerate=30).start()
        time.sleep(1)
        print('DONE.')
        
    def quit(self):
        self.videostream.stop()
        return 

    def check_tf(self):
        imH = 480
        imW = 640
        # Grab frame from video stream
        frame = cv2.flip(self.videostream.read(), 0)
        frame_rgb = cv2.cvtColor(frame, cv2.COLOR_BGR2RGB)
        frame_resized = cv2.resize(frame_rgb, (self.width, self.height))
        input_data = np.expand_dims(frame_resized, axis=0)

        # Normalize pixel values if using a floating model (i.e. if model is non-quantized)
        if self.floating_model:
            input_data = (np.float32(input_data) - input_mean) / input_std

        # Perform the actual detection by running the model with the image as input
        self.interpreter.set_tensor(self.input_details[0]['index'],input_data)
        self.interpreter.invoke()

        # Retrieve detection results
        boxes = self.interpreter.get_tensor(self.output_details[0]['index'])[0] # Bounding box coordinates of detected objects
        classes = self.interpreter.get_tensor(self.output_details[1]['index'])[0] # Class index of detected objects
        scores = self.interpreter.get_tensor(self.output_details[2]['index'])[0] # Confidence of detected objects
        #num = interpreter.get_tensor(output_details[3]['index'])[0]  # Total number of detected objects (inaccurate and not needed)

        # Loop over all detections and draw detection box if confidence is above minimum threshold
        if ((scores[0] > self.min_conf_threshold) and (scores[0] <= 1.0) and self.labels[int(classes[0])].upper() == "PERSON"):
            # Get bounding box coordinates and draw box
            # Interpreter can return coordinates that are outside of image dimensions, need to force them to be within image using max() and min()                
            ymin = int(max(1,(boxes[0][0] * imH)))
            xmin = int(max(1,(boxes[0][1] * imW)))
            ymax = int(min(imH,(boxes[0][2] * imH)))
            xmax = int(min(imW,(boxes[0][3] * imW)))
            if (xmin+xmax)//2 < (2*imW//5):
                return 'L'
            elif (xmin+xmax)//2 >= (2*imW//5) and (xmin+xmax)//2 <= (3*imW//5):
                return 'S'
            elif (xmin+xmax)//2 > (3*imW//5):
                return 'R'
        return 'N'   # nothing detected in frame 
