vtattyba/NASA-Micro-G-NeXT/AMSAR 1.0/FInal 1.0/Final2/acceleromter.py

import time
import board
import digitalio
import busio
import math
import adafruit_lis3dh

i2c = busio.I2C(board.SCL, board.SDA)
int1 = digitalio.DigitalInOut(board.D17)
lis3dh = adafruit_lis3dh.LIS3DH_I2C(i2c, int1=int1)

def accel():
    while True:
        x, y, z = lis3dh.acceleration
        one = math.pow(x, 2)
        two = math.pow(y, 2)
        three = math.pow(z, 2)
        summ = one + two + three
        sq = math.sqrt(summ)

        norm = (sq // 9.81)

        print(str(norm) + "g")
	
        if norm >= 2:
                print("Detected G")
                break
    return 1
