vtattyba/NASA-Micro-G-NeXT/AMSAR 1.0/Software/Ultra_Sonic_sensor/uss_1.py

#!/usr/bin/python
import RPi.GPIO as GPIO
import time
GPIO.setwarnings(False)
count = 0
tg = True
distance = 0
GPIO.setmode(GPIO.BOARD)
PIN_TRIGGER = 40
PIN_ECHO = 32
GPIO.setup(PIN_TRIGGER, GPIO.OUT)
GPIO.setup(PIN_ECHO, GPIO.IN)
try:
  while tg:
   
    GPIO.output(PIN_TRIGGER, GPIO.LOW)

    #print "Waiting for sensor to settle"

    time.sleep(.1)

    #print "Calculating distance"

    GPIO.output(PIN_TRIGGER, GPIO.HIGH)

    time.sleep(0.00001)

    GPIO.output(PIN_TRIGGER, GPIO.LOW)

    while GPIO.input(PIN_ECHO)==0:
          pulse_start_time = time.time()
    while GPIO.input(PIN_ECHO)==1:
          pulse_end_time = time.time()
    pulse_duration = pulse_end_time - pulse_start_time
    distance = round(pulse_duration * 17150, 2)
    print ("Distance:",distance,"cm")
          

except KeyboardInterrupt:
  GPIO.cleanup()

"""exec(open("hello.py").read());""" 
