vtattyba/NASA-Micro-G-NeXT/(commit log)

2019-10-10 Added Tensor Flow Object Detection Documentation
2019-10-20 Ultra Sonic sensor Object detection
    Ultra Sonic sensor Object detection in arduino
2019-10-20 Create sensors
    Folder for Ultrasonic sensor
2019-10-20 Added ulra sonic sensor arduino files
    add the "median filter" folder into the libraries into arduino libraries and run "new_sens.ino"
2019-10-20 added initial cad models and meeting documentation
2019-10-29 Create Accelerometer.ino
    Magnitude threshold subject to change
2019-10-29 pseudo code for motor
2019-10-29 Loaded on Pi
    [census_test.csv, test_labels.csv, train_higgs_test.csv, train_labels.csv]
2019-10-30 Folder for Object Detection, rdy for master
    [census_test.csv, test_labels.csv, train_higgs_test.csv, train_labels.csv]
2019-10-30 Motor Control folder made
2020-03-18 uss and servo
    uploaded working two ultrasonic sensor with servo motor
2020-07-10 Acceleromter file added
2020-08-13 Added Servo functionality for system
2020-08-13 Added PCB connection and uss resistor file
2020-08-17 USS servo and sdr work together
2020-11-17 Organized Git
    [census_test.csv, test_labels.csv, train_higgs_test.csv, train_labels.csv]
2020-11-17 Created an AMSAR 1.0 folder for past year stuff
    [census_test.csv, test_labels.csv, train_higgs_test.csv, train_labels.csv]
2021-05-21 motor working, servo no puedo
2021-05-21 manual to autonomous mode switching WORKING. manual mode 100% done
2021-06-02 updated images pcb
